adafruit/Adafruit-2.23-inch-Monochrome-OLED-Bonnet-PCB/Adafruit 2.23-inch Monochrome OLED Bonnet.brd

## EAGLE design Adafruit 2.23-inch Monochrome OLED Bonnet.brd (2020-06-04)

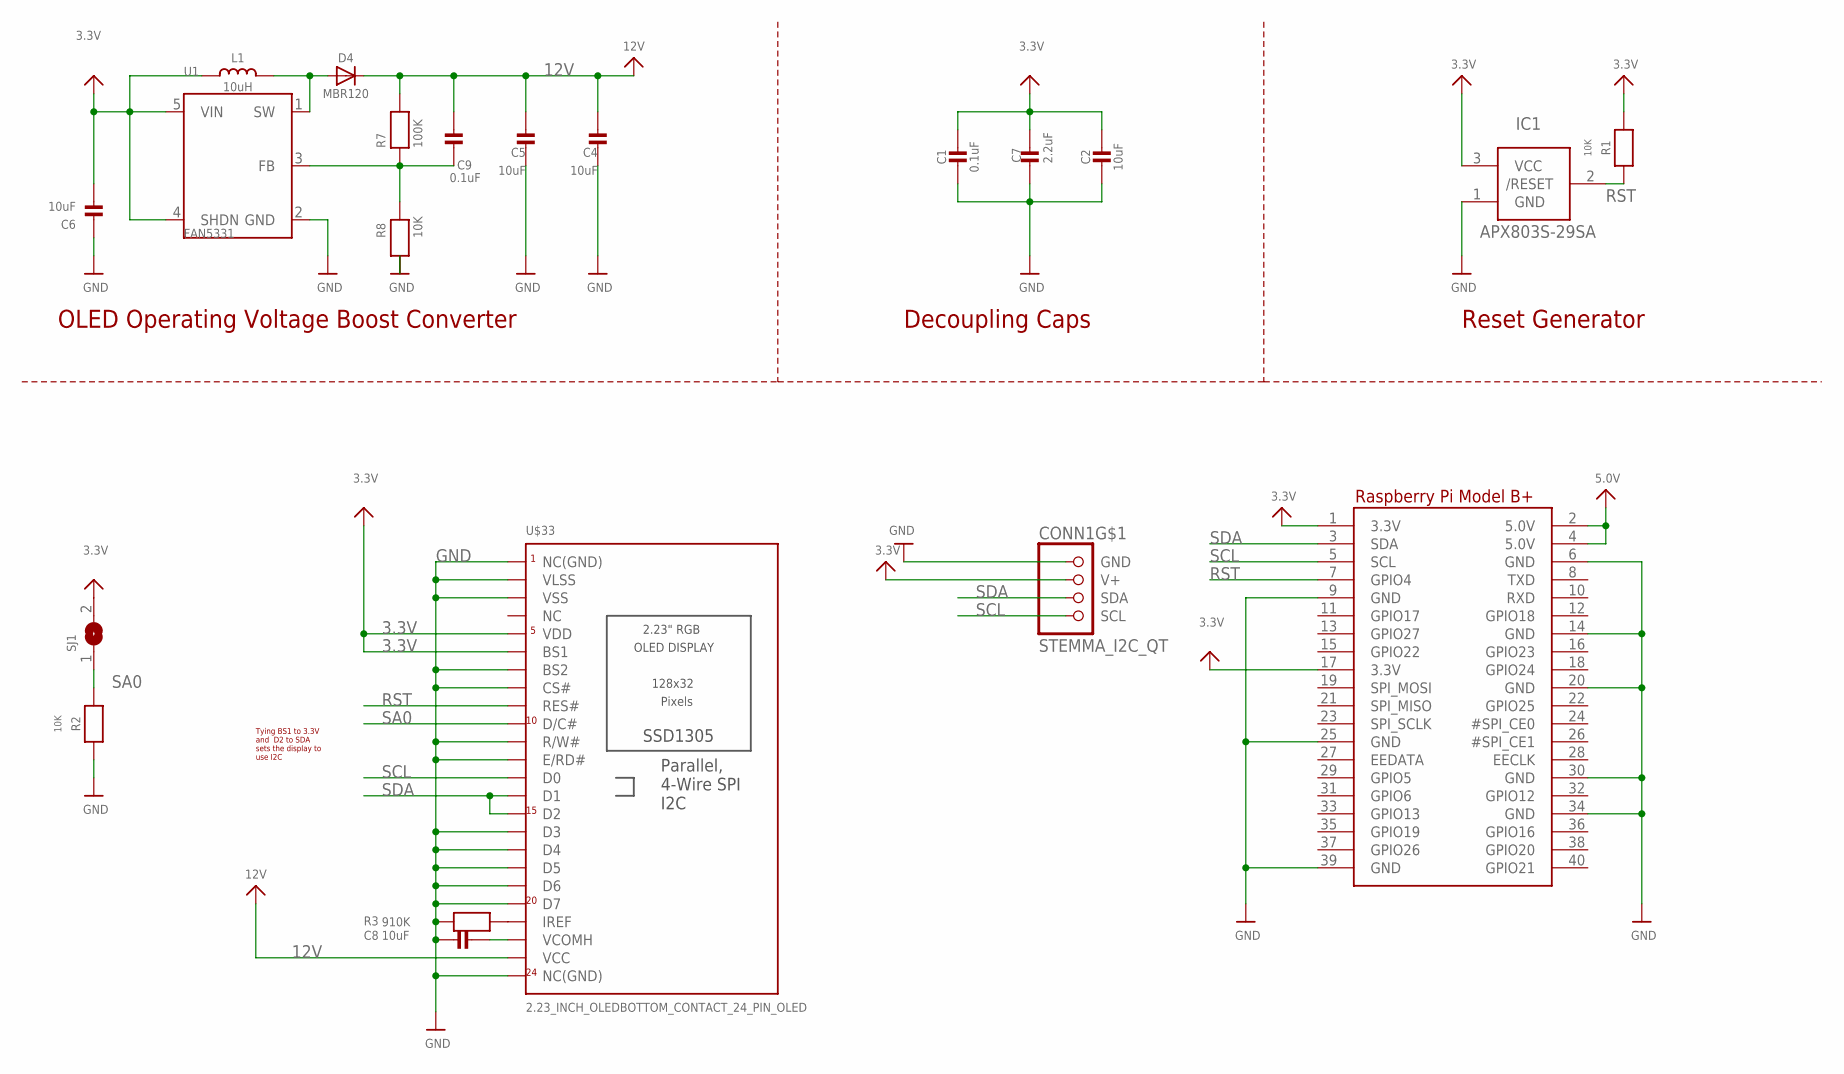
[picture p2: schematic Adafruit 2.23-inch Monochrome OLED Bonnet.sch]

Parts:
C1, C9: 0.1uF; 0603-NO
C2, C4, C5, C6, C8: 10uF; 0805-NO
C7: 2.2uF; 0805-NO
CONN1: STEMMA_I2C_QT; JST_SH4
D4: MBR120; SOD-123
IC1: APX803S-29SA; SOT23
L1: 10uH; INDUCTOR_1007
R1, R2, R8: 10K; 0603-NO
R3: 910K; 0805-NO
R7: 100K; 0603-NO
RPI1: RASPBERRYPI_BPLUS_BONNETSMT; PI_BONNET_SMT
SJ1: SOLDERJUMPER; SOLDERJUMPER_ARROW_NOPASTE
U1: FAN5331; SOT23-5
U$33: 2.23_INCH_OLEDBOTTOM_CONTACT_24_PIN_OLED; 2.23OLED_BOTTOM_CONTACT

Connections:
3.3V: C1.1, C2.1, C6.2, C7.2, CONN1.2 (V+), IC1.3 (VCC), L1.P$1 (1), R1.2, RPI1.1 (3.3V), RPI1.17 (3.3V), SJ1.2, U1.4 (SHDN), U1.5 (VIN), U$33.5 (VDD), U$33.6 (BS1)
5.0V: RPI1.2 (5.0V), RPI1.4 (5.0V)
12V: C4.2, C5.2, C9.1, D4.C, R7.2, U$33.23 (VCC)
GND: C1.2, C2.2, C4.1, C5.1, C6.1, C7.1, C8.1, CONN1.1 (GND), IC1.1 (GND), R2.1, R3.1, R8.1, RPI1.6 (GND), RPI1.9 (GND), RPI1.14 (GND), RPI1.20 (GND), RPI1.25 (GND), RPI1.30 (GND), RPI1.34 (GND), RPI1.39 (GND), U1.2 (GND), U$33.1 (NC(GND)), U$33.2 (VLSS), U$33.3 (VSS), U$33.7 (BS2), U$33.8 (CS#), U$33.11 (R/W#), U$33.12 (E/RD#), U$33.16 (D3), U$33.17 (D4), U$33.18 (D5), U$33.19 (D6), U$33.20 (D7), U$33.24 (NC(GND)), U$33.SPRT1 (NC(GND)), U$33.SPRT2 (NC(GND))
unnamed: R3.2, U$33.21 (IREF)
unnamed: D4.A, L1.P$2 (2), U1.1 (SW)
unnamed: C9.2, R7.1, R8.2, U1.3 (FB)
unnamed: C8.2, U$33.22 (VCOMH)
RST: IC1.2 (/RESET), R1.1, RPI1.7 (GPIO4), U$33.9 (RES#)
SA0: R2.2, SJ1.1, U$33.10 (D/C#)
SCL: CONN1.4 (SCL), RPI1.5 (SCL), U$33.13 (D0)
SDA: CONN1.3 (SDA), RPI1.3 (SDA), U$33.14 (D1), U$33.15 (D2)

Notes on the sheet:
OLED Operating Voltage Boost Converter
Tying BS1 to 3.3V and D2 to SDA sets the display to use I2C
Decoupling Caps
Reset Generator

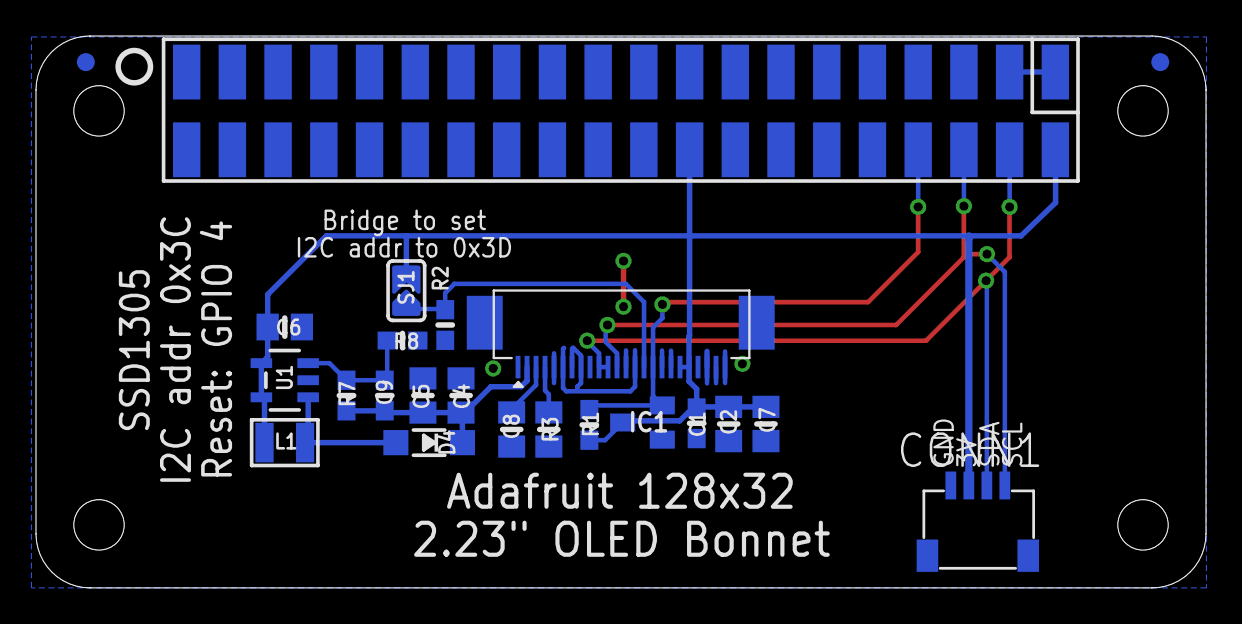
[picture p3: board Adafruit 2.23-inch Monochrome OLED Bonnet.brd from below]

Board: 2 copper layers, 65.0 x 30.7 mm, 23 parts (20 on the bottom side), 12 nets.

Other parts of the board:
U$2: PCBFEAT-REV-040
U$11: STEMMAQT
